InderveerS/LineFollower/3D Models/wheel.SLDPRT

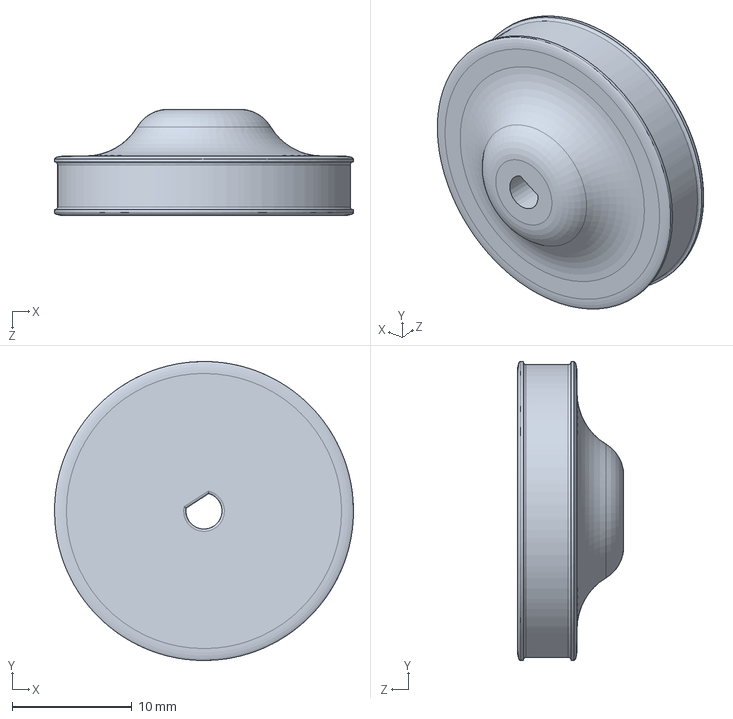
[picture p1: CAD file, 2026-05-06]
3D Models/wheel.SLDPRT
25.0 x 25.0 x 8.90 mm
