InderveerS/LineFollower/3D Models/frrontMount.SLDPRT

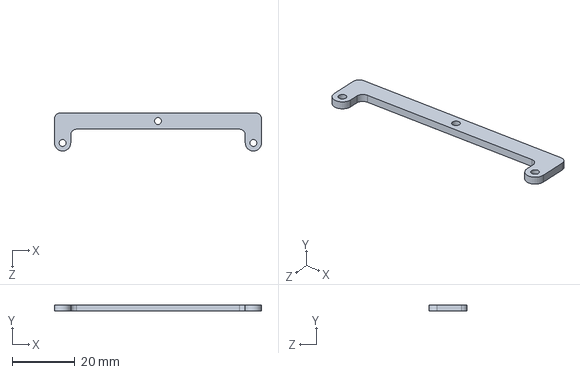
[picture p2: CAD file, 2026-05-06]
3D Models/frrontMount.SLDPRT
66.2 x 2.00 x 12.2 mm
