InderveerS/LineFollower/3D Models/frontMount.SLDPRT

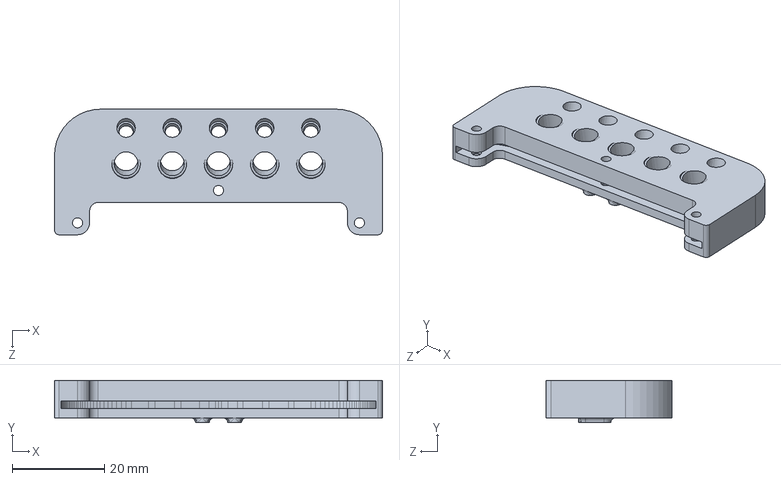
[picture p3: CAD file, 2026-05-06]
3D Models/frontMount.SLDPRT
71.0 x 9.12 x 27.2 mm
