InderveerS/LineFollower/3D Models/OPTO-TH_BD3.8-P2.54_SFH-309-FA-4.step

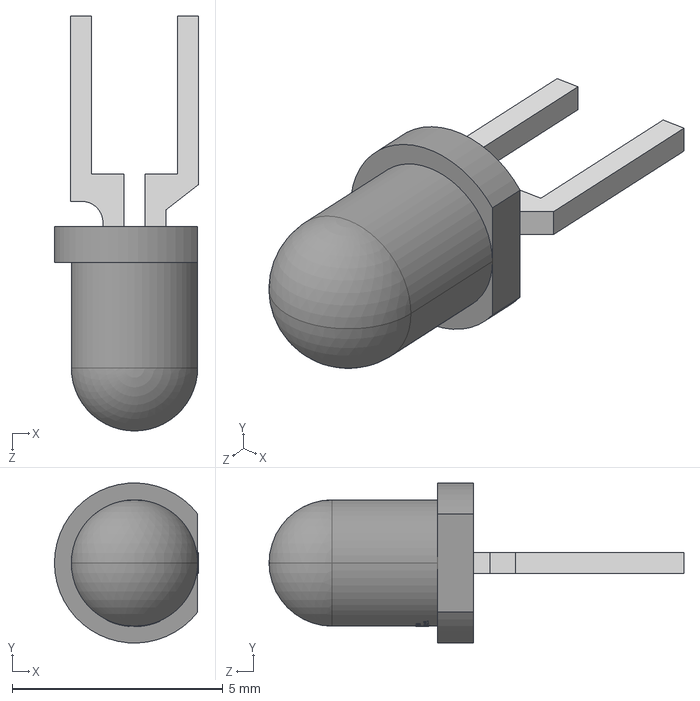
[picture p4: CAD file, 2026-05-06]
3D Models/OPTO-TH_BD3.8-P2.54_SFH-309-FA-4.step
3.42 x 3.80 x 9.85 mm
