InderveerS/LineFollower/3D Models/Micro Metal Gear Motor.SLDPRT

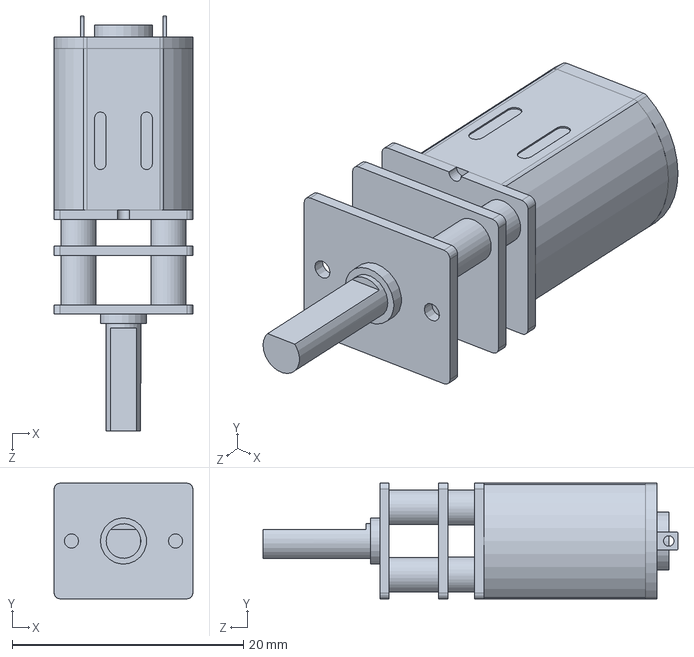
[picture p5: CAD file, 2026-05-06]
3D Models/Micro Metal Gear Motor.SLDPRT
12.0 x 10.0 x 35.9 mm
