InderveerS/LineFollower/3D Models/LED-TH_5mm_YG.step

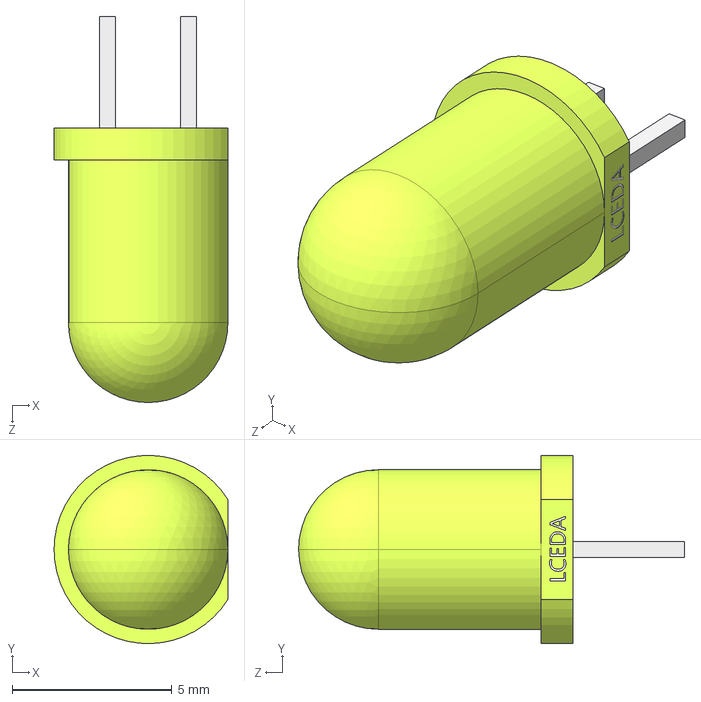
[picture p6: CAD file, 2026-05-06]
3D Models/LED-TH_5mm_YG.step
5.45 x 5.90 x 12.1 mm
