InderveerS/LineFollower/3D Models/motorMount.SLDPRT

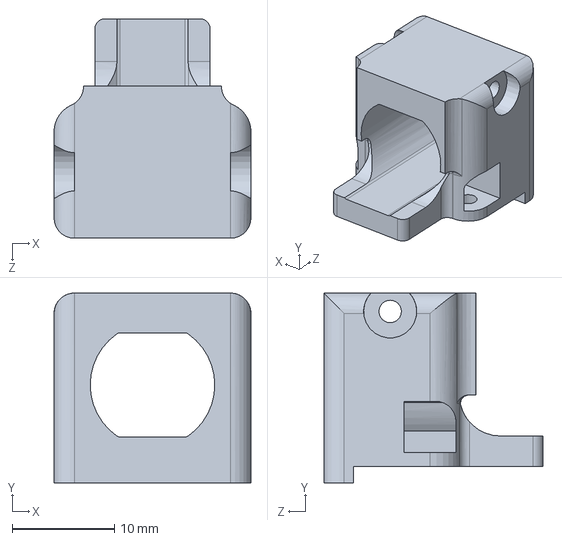
[picture p7: CAD file, 2026-05-06]
3D Models/motorMount.SLDPRT
19.3 x 18.6 x 21.5 mm
