InderveerS/LineFollower/finalTuneTest.xlsx

=~=~=~=~=~=~=~=~=~=~=~= PuTTY log 2026.09.06 22:22:52 =~=~=~=~=~=~=~=~=~=~=~=
target_mmps | left_mmps | right_mmps | left_duty | right_duty
200 | 0 | 0 | 39 | 39
200 | 9 | 0 | 39 | 39
200 | 19 | 9 | 39 | 39
200 | 48 | 28 | 37 | 38
200 | 67 | 57 | 36 | 37
200 | 86 | 86 | 35 | 35
200 | 115 | 105 | 34 | 34
200 | 125 | 125 | 33 | 33
200 | 144 | 134 | 32 | 33
200 | 153 | 144 | 32 | 32
200 | 153 | 153 | 32 | 32
200 | 163 | 163 | 31 | 31
200 | 173 | 173 | 31 | 31
200 | 182 | 182 | 30 | 30
200 | 182 | 192 | 30 | 30
200 | 182 | 192 | 30 | 30
200 | 182 | 192 | 30 | 30
200 | 192 | 192 | 30 | 30
200 | 202 | 192 | 29 | 30
200 | 202 | 202 | 29 | 29
200 | 202 | 202 | 29 | 29
200 | 202 | 202 | 29 | 29
200 | 202 | 211 | 29 | 29
200 | 202 | 202 | 29 | 29
200 | 211 | 211 | 29 | 29
200 | 202 | 211 | 29 | 29
200 | 211 | 211 | 29 | 29
200 | 211 | 211 | 29 | 29
200 | 211 | 202 | 29 | 29
200 | 211 | 211 | 29 | 29
200 | 211 | 202 | 29 | 29
200 | 211 | 211 | 29 | 29
200 | 211 | 211 | 28 | 29
200 | 211 | 211 | 28 | 29
200 | 211 | 211 | 28 | 29
200 | 211 | 211 | 28 | 29
200 | 211 | 221 | 28 | 28
200 | 211 | 211 | 28 | 28
200 | 211 | 221 | 28 | 28
200 | 211 | 211 | 28 | 28
200 | 211 | 202 | 28 | 29
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
