InderveerS/LineFollower/PITuneTest1.xlsx

=~=~=~=~=~=~=~=~=~=~=~= PuTTY log 2026.09.06 21:41:21 =~=~=~=~=~=~=~=~=~=~=~=
target_mmps | left_mmps | right_mmps | left_duty | right_duty
200 | 0 | 0 | 32 | 32
200 | 0 | 0 | 34 | 34
200 | 19 | 9 | 35 | 35
200 | 28 | 28 | 36 | 36
200 | 48 | 48 | 36 | 36
200 | 76 | 76 | 35 | 35
200 | 86 | 96 | 36 | 35
200 | 105 | 105 | 35 | 35
200 | 125 | 125 | 35 | 35
200 | 134 | 134 | 35 | 35
200 | 144 | 153 | 35 | 34
200 | 163 | 163 | 34 | 34
200 | 173 | 173 | 34 | 34
200 | 182 | 192 | 33 | 33
200 | 202 | 192 | 32 | 33
200 | 202 | 202 | 32 | 32
200 | 211 | 211 | 32 | 32
200 | 211 | 211 | 32 | 31
200 | 211 | 211 | 31 | 31
200 | 221 | 221 | 31 | 31
200 | 221 | 221 | 31 | 30
200 | 221 | 211 | 30 | 31
200 | 221 | 221 | 30 | 30
200 | 221 | 221 | 30 | 30
200 | 221 | 221 | 30 | 30
200 | 230 | 221 | 29 | 30
200 | 230 | 221 | 29 | 29
200 | 230 | 221 | 28 | 29
200 | 230 | 221 | 28 | 29
200 | 221 | 230 | 28 | 28
200 | 221 | 221 | 28 | 28
200 | 221 | 221 | 28 | 28
200 | 221 | 211 | 28 | 29
200 | 230 | 211 | 27 | 29
200 | 221 | 221 | 27 | 28
200 | 221 | 211 | 27 | 28
200 | 221 | 221 | 27 | 28
200 | 211 | 221 | 27 | 27
200 | 221 | 211 | 27 | 28
200 | 211 | 221 | 27 | 27
200 | 211 | 211 | 27 | 28
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
