InderveerS/LineFollower/pOnlyTuneTest.xlsx

=~=~=~=~=~=~=~=~=~=~=~= PuTTY log 2026.09.06 17:12:21 =~=~=~=~=~=~=~=~=~=~=~=
target_mmps | left_mmps | right_mmps | left_duty | right_duty
200 | 0 | 0 | 30 | 30
200 | 0 | 0 | 30 | 30
200 | 9 | 9 | 30 | 30
200 | 19 | 28 | 29 | 29
200 | 48 | 38 | 28 | 28
200 | 67 | 57 | 27 | 27
200 | 86 | 67 | 25 | 27
200 | 105 | 76 | 24 | 26
200 | 105 | 96 | 24 | 25
200 | 105 | 96 | 24 | 25
200 | 105 | 105 | 24 | 24
200 | 105 | 105 | 24 | 24
200 | 115 | 105 | 24 | 24
200 | 125 | 125 | 23 | 23
200 | 125 | 125 | 23 | 23
200 | 134 | 134 | 23 | 23
200 | 125 | 134 | 23 | 23
200 | 134 | 134 | 23 | 23
200 | 134 | 134 | 23 | 23
200 | 134 | 134 | 23 | 23
400 | 144 | 144 | 50 | 50
400 | 144 | 144 | 50 | 50
400 | 163 | 163 | 49 | 49
400 | 173 | 173 | 48 | 48
400 | 192 | 192 | 47 | 47
400 | 211 | 211 | 46 | 46
400 | 230 | 230 | 45 | 45
400 | 240 | 240 | 44 | 44
400 | 250 | 250 | 44 | 44
400 | 259 | 259 | 43 | 43
400 | 259 | 259 | 43 | 43
400 | 269 | 279 | 43 | 42
400 | 279 | 279 | 42 | 42
400 | 279 | 279 | 42 | 42
400 | 288 | 288 | 42 | 42
400 | 288 | 288 | 42 | 42
400 | 288 | 288 | 42 | 42
400 | 298 | 298 | 41 | 41
400 | 288 | 298 | 42 | 41
400 | 298 | 298 | 41 | 41
400 | 298 | 307 | 41 | 41
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
