InderveerS/LineFollower/PCB/lineFollower.kicad_pcb

## KiCad design PCB/lineFollower.kicad_pcb (2026-05-06)

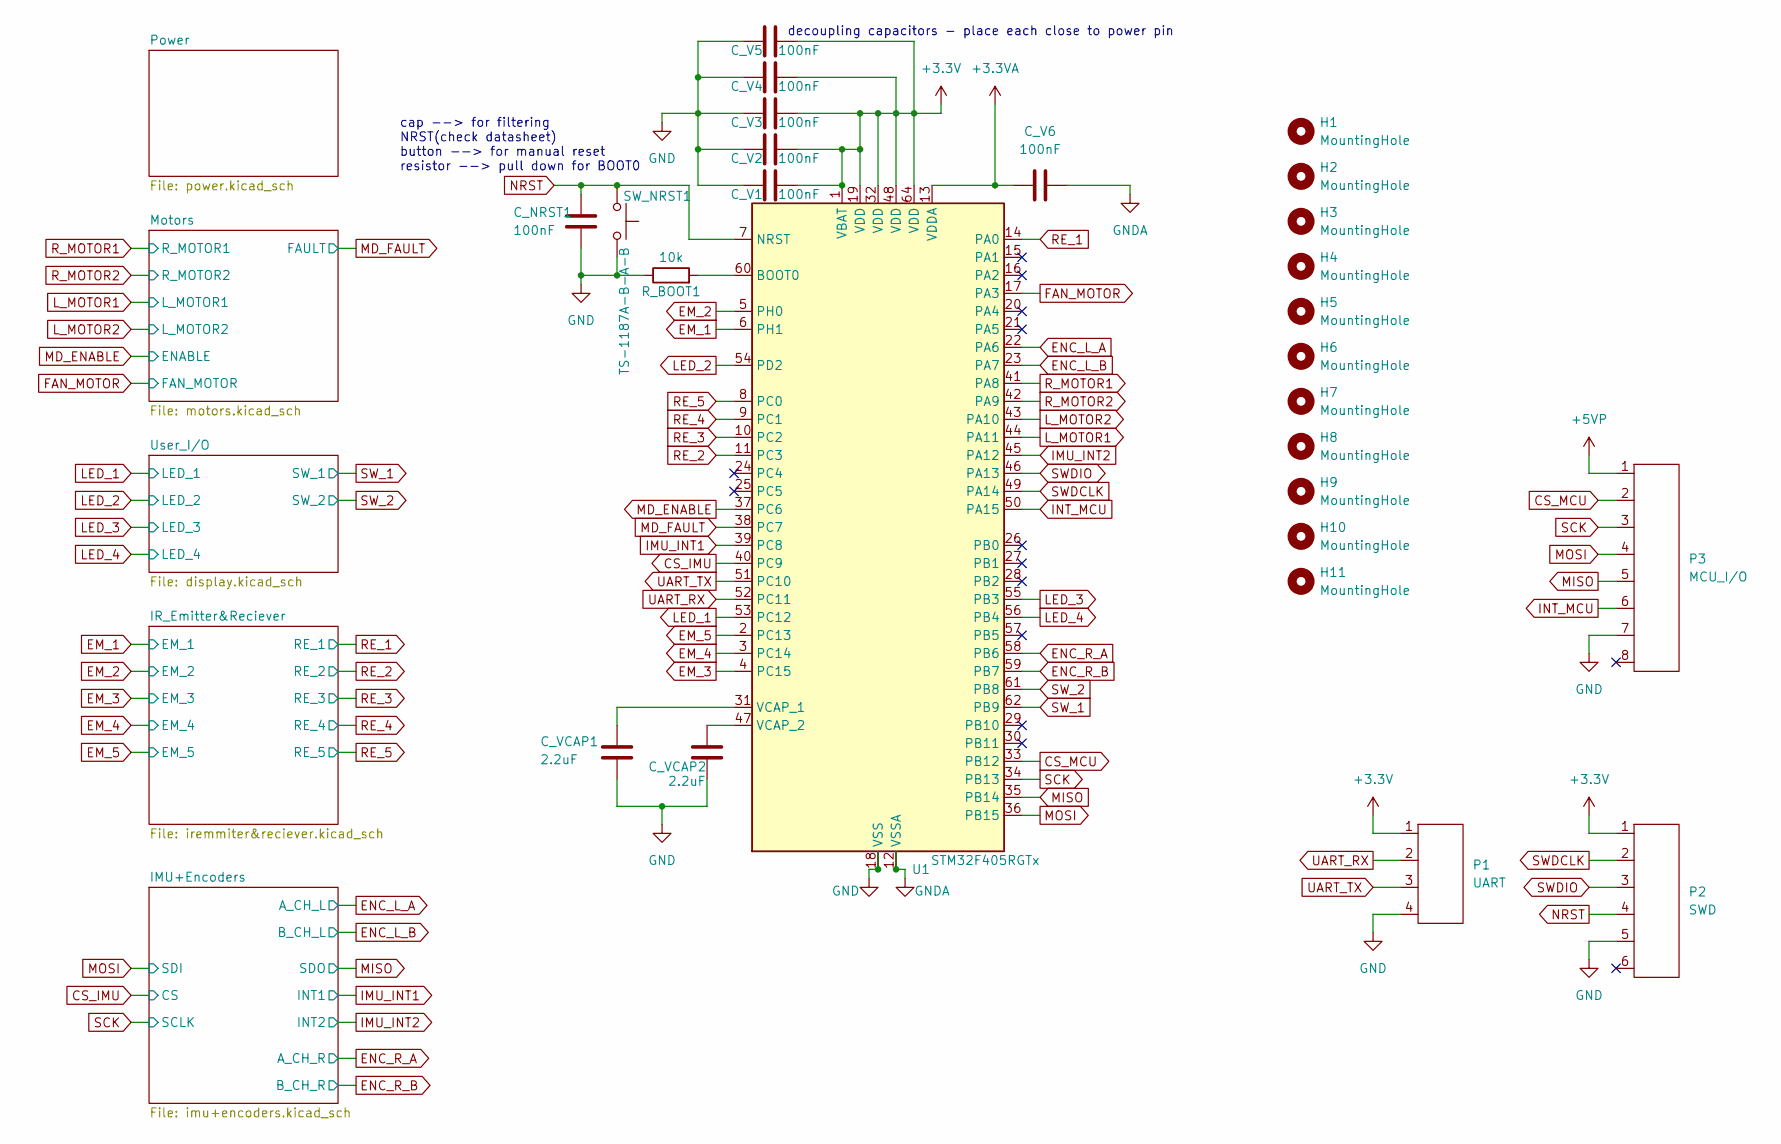
[picture p8: schematic lineFollower.kicad_sch]

Parts:
C_NRST1: 100nF; C_0603_1608Metric
C_V1, C_V2, C_V3, C_V4, C_V5, C_V6: 100nF; C_0603_1608Metric
C_VCAP1, C_VCAP2: 2.2uF; C_0603_1608Metric
H1, H2, H3, H4, H5, H6, H7, H8, H9, H10, H11: MountingHole; MountingHole_2.2mm_M2
P1: UART; PinHeader_1x04_P2.54mm_Vertical
P2: SWD; PinHeader_1x06_P2.54mm_Vertical
P3: MCU_I/O; PinHeader_1x08_P2.54mm_Vertical
R_BOOT1: 10k; R_0603_1608Metric
SW_NRST1: TS-1187A-B-A-B
U1: STM32F405RGTx; LQFP-64_10x10mm_P0.5mm

Connections:
+3.3V: C_V1.2, C_V2.2, C_V3.2, C_V4.2, C_V5.2, P1.1, P2.1, U1.1 (VBAT), U1.19 (VDD), U1.32 (VDD), U1.48 (VDD), U1.64 (VDD); also elsewhere on the board
+3.3VA: C_V6.1, U1.13 (VDDA); also elsewhere on the board
+5VP: P3.1; also elsewhere on the board
CS_IMU: U1.40 (PC9); also elsewhere on the board
CS_MCU: P3.2, U1.33 (PB12)
EM_1: U1.6 (PH1); also elsewhere on the board
EM_2: U1.5 (PH0); also elsewhere on the board
EM_3: U1.4 (PC15); also elsewhere on the board
EM_4: U1.3 (PC14); also elsewhere on the board
EM_5: U1.2 (PC13); also elsewhere on the board
ENC_L_A: U1.22 (PA6); also elsewhere on the board
ENC_L_B: U1.23 (PA7); also elsewhere on the board
ENC_R_A: U1.58 (PB6); also elsewhere on the board
ENC_R_B: U1.59 (PB7); also elsewhere on the board
FAN_MOTOR: U1.17 (PA3); also elsewhere on the board
GND: C_NRST1.2, C_V1.1, C_V2.1, C_V3.1, C_V4.1, C_V5.1, C_V6.2, C_VCAP1.2, C_VCAP2.2, P1.4, P2.5, P3.7, R_BOOT1.1, SW_NRST1.2, U1.12 (VSSA), U1.18 (VSS), U1.63 (VSS); also elsewhere on the board
IMU_INT1: U1.39 (PC8); also elsewhere on the board
IMU_INT2: U1.45 (PA12); also elsewhere on the board
INT_MCU: P3.6, U1.50 (PA15)
LED_1: U1.53 (PC12); also elsewhere on the board
LED_2: U1.54 (PD2); also elsewhere on the board
LED_3: U1.55 (PB3); also elsewhere on the board
LED_4: U1.56 (PB4); also elsewhere on the board
L_MOTOR1: U1.44 (PA11); also elsewhere on the board
L_MOTOR2: U1.43 (PA10); also elsewhere on the board
MD_ENABLE: U1.37 (PC6); also elsewhere on the board
MD_FAULT: U1.38 (PC7); also elsewhere on the board
MISO: P3.5, U1.35 (PB14); also elsewhere on the board
MOSI: P3.4, U1.36 (PB15); also elsewhere on the board
NRST: C_NRST1.1, P2.4, SW_NRST1.1, U1.7 (NRST)
unnamed: R_BOOT1.2, U1.60 (BOOT0)
unnamed: C_VCAP1.1, U1.31 (VCAP_1)
unnamed: C_VCAP2.1, U1.47 (VCAP_2)
RE_1: U1.14 (PA0); also elsewhere on the board
RE_2: U1.11 (PC3); also elsewhere on the board
RE_3: U1.10 (PC2); also elsewhere on the board
RE_4: U1.9 (PC1); also elsewhere on the board
RE_5: U1.8 (PC0); also elsewhere on the board
R_MOTOR1: U1.41 (PA8); also elsewhere on the board
R_MOTOR2: U1.42 (PA9); also elsewhere on the board
SCK: P3.3, U1.34 (PB13); also elsewhere on the board
SWDCLK: P2.2, U1.49 (PA14)
SWDIO: P2.3, U1.46 (PA13)
SW_1: U1.62 (PB9); also elsewhere on the board
SW_2: U1.61 (PB8); also elsewhere on the board
UART_RX: P1.2, U1.52 (PC11)
UART_TX: P1.3, U1.51 (PC10)

Notes on the sheet:
decoupling capacitors - place each close to power pin
cap --> for filtering NRST(check datasheet) button --> for manual reset resistor --> pull down for BOOT0

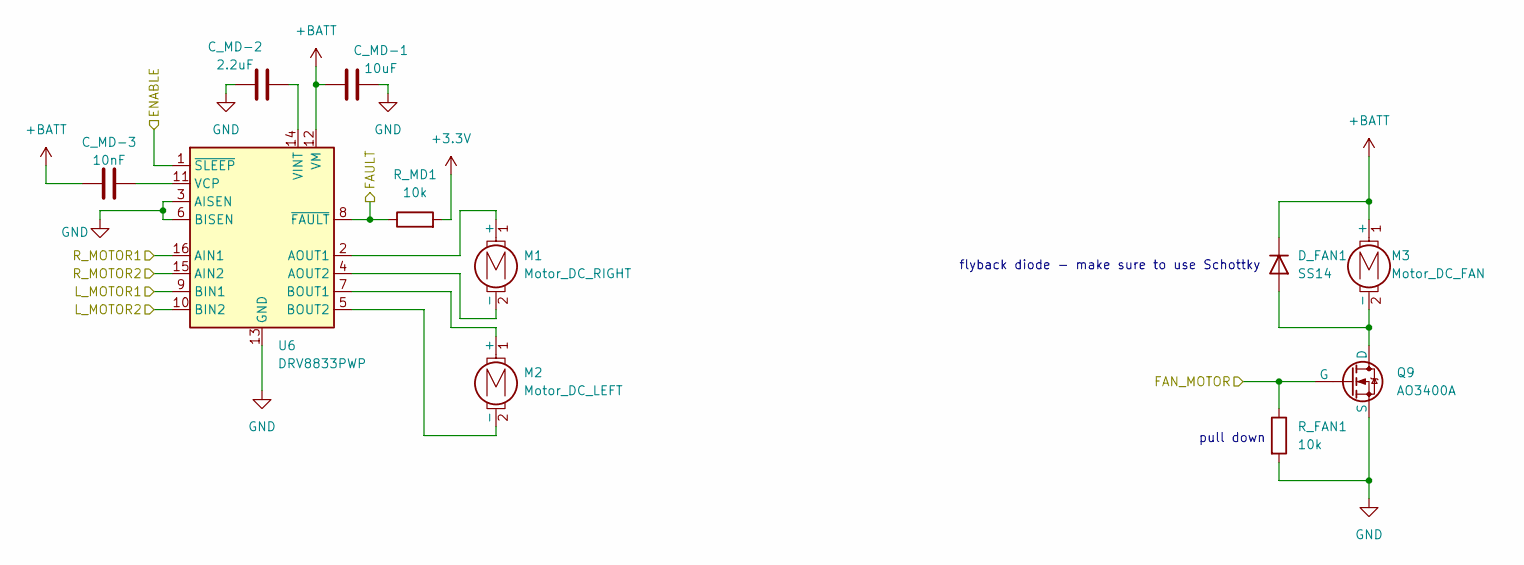
[picture p9: schematic motors.kicad_sch]

Parts:
C_MD-1: 10uF; C_0805_2012Metric
C_MD-2: 2.2uF; C_0603_1608Metric
C_MD-3: 10nF; C_0603_1608Metric
D_FAN1: SS14; D_SMA
M1: Motor_DC_RIGHT; PinHeader_1x02_P2.54mm_Vertical
M2: Motor_DC_LEFT; PinHeader_1x02_P2.54mm_Vertical
M3: Motor_DC_FAN; PinHeader_1x02_P2.54mm_Vertical
Q9: AO3400A
R_FAN1: 10k; R_0603_1608Metric
R_MD1: 10k; R_0603_1608Metric
U6: DRV8833PWP; HTSSOP-16-1EP_4.4x5mm_P0.65mm_EP3.4x5mm_Mask2.46x2.31mm_The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

Connections:
+3.3V: R_MD1.2; also elsewhere on the board
+BATT: C_MD-1.1, C_MD-3.1, D_FAN1.1 (K), M3.1 (+), U6.12 (VM); also elsewhere on the board
FAN_MOTOR: Q9.2 (G), R_FAN1.1; also elsewhere on the board
GND: C_MD-1.2, C_MD-2.1, Q9.3 (S), R_FAN1.2, U6.3 (AISEN), U6.6 (BISEN), U6.13 (GND), U6.17 (GND); also elsewhere on the board
L_MOTOR1: U6.9 (BIN1); also elsewhere on the board
L_MOTOR2: U6.10 (BIN2); also elsewhere on the board
MD_ENABLE: U6.1 (~SLEEP); also elsewhere on the board
MD_FAULT: R_MD1.1, U6.8 (~FAULT); also elsewhere on the board
unnamed: D_FAN1.2 (A), M3.2 (-), Q9.1 (D)
unnamed: M1.1 (+), U6.2 (AOUT1)
unnamed: M1.2 (-), U6.4 (AOUT2)
unnamed: M2.1 (+), U6.7 (BOUT1)
unnamed: M2.2 (-), U6.5 (BOUT2)
unnamed: C_MD-3.2, U6.11 (VCP)
unnamed: C_MD-2.2, U6.14 (VINT)
R_MOTOR1: U6.16 (AIN1); also elsewhere on the board
R_MOTOR2: U6.15 (AIN2); also elsewhere on the board

Notes on the sheet:
pull down
flyback diode - make sure to use Schottky

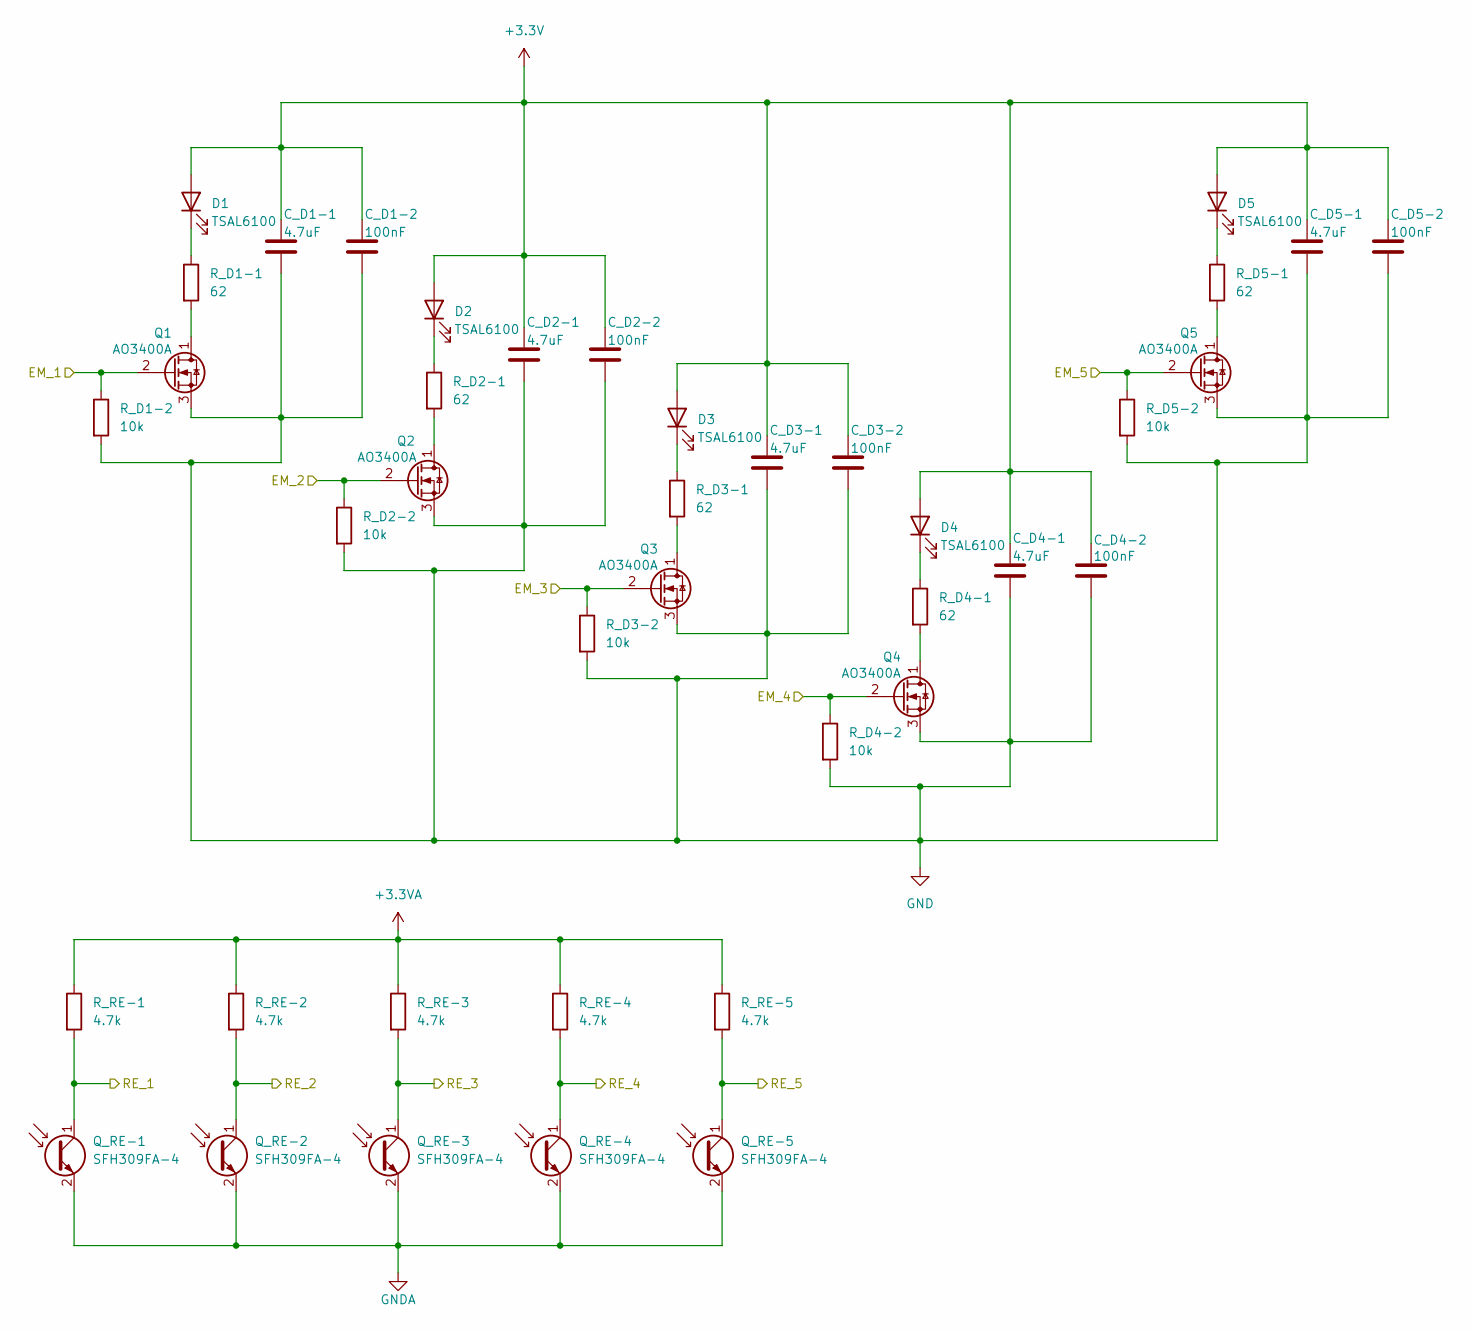
[picture p10: schematic iremmiter&reciever.kicad_sch]

Parts:
C_D1-1, C_D2-1, C_D3-1, C_D4-1, C_D5-1: 4.7uF; C_0805_2012Metric
C_D1-2, C_D2-2, C_D3-2, C_D4-2, C_D5-2: 100nF; C_0603_1608Metric
D1, D2, D3, D4, D5: TSAL6100; PinHeader_1x02_P2.54mm_Vertical
Q1, Q2, Q3, Q4, Q5: AO3400A
Q_RE-1, Q_RE-2, Q_RE-3, Q_RE-4, Q_RE-5: SFH309FA-4; PinHeader_1x02_P2.54mm_Vertical
R_D1-1, R_D2-1, R_D3-1, R_D4-1, R_D5-1: 62; R_0603_1608Metric
R_D1-2, R_D2-2, R_D3-2, R_D4-2, R_D5-2: 10k; R_0603_1608Metric
R_RE-1, R_RE-2, R_RE-3, R_RE-4, R_RE-5: 4.7k; R_0603_1608Metric

Connections:
+3.3V: C_D1-1.1, C_D1-2.1, C_D2-1.1, C_D2-2.1, C_D3-1.1, C_D3-2.1, C_D4-1.1, C_D4-2.1, C_D5-1.1, C_D5-2.1, D1.2 (A), D2.2 (A), D3.2 (A), D4.2 (A), D5.2 (A); also elsewhere on the board
+3.3VA: R_RE-1.1, R_RE-2.1, R_RE-3.1, R_RE-4.1, R_RE-5.1; also elsewhere on the board
EM_1: Q1.2 (G), R_D1-2.1; also elsewhere on the board
EM_2: Q2.2 (G), R_D2-2.1; also elsewhere on the board
EM_3: Q3.2 (G), R_D3-2.1; also elsewhere on the board
EM_4: Q4.2 (G), R_D4-2.1; also elsewhere on the board
EM_5: Q5.2 (G), R_D5-2.1; also elsewhere on the board
GND: C_D1-1.2, C_D1-2.2, C_D2-1.2, C_D2-2.2, C_D3-1.2, C_D3-2.2, C_D4-1.2, C_D4-2.2, C_D5-1.2, C_D5-2.2, Q1.3 (S), Q2.3 (S), Q3.3 (S), Q4.3 (S), Q5.3 (S), Q_RE-1.2 (E), Q_RE-2.2 (E), Q_RE-3.2 (E), Q_RE-4.2 (E), Q_RE-5.2 (E), R_D1-2.2, R_D2-2.2, R_D3-2.2, R_D4-2.2, R_D5-2.2; also elsewhere on the board
unnamed: D1.1 (K), R_D1-1.1
unnamed: D2.1 (K), R_D2-1.1
unnamed: D3.1 (K), R_D3-1.1
unnamed: D4.1 (K), R_D4-1.1
unnamed: D5.1 (K), R_D5-1.1
unnamed: Q1.1 (D), R_D1-1.2
unnamed: Q2.1 (D), R_D2-1.2
unnamed: Q3.1 (D), R_D3-1.2
unnamed: Q4.1 (D), R_D4-1.2
unnamed: Q5.1 (D), R_D5-1.2
RE_1: Q_RE-1.1 (C), R_RE-1.2; also elsewhere on the board
RE_2: Q_RE-2.1 (C), R_RE-2.2; also elsewhere on the board
RE_3: Q_RE-3.1 (C), R_RE-3.2; also elsewhere on the board
RE_4: Q_RE-4.1 (C), R_RE-4.2; also elsewhere on the board
RE_5: Q_RE-5.1 (C), R_RE-5.2; also elsewhere on the board

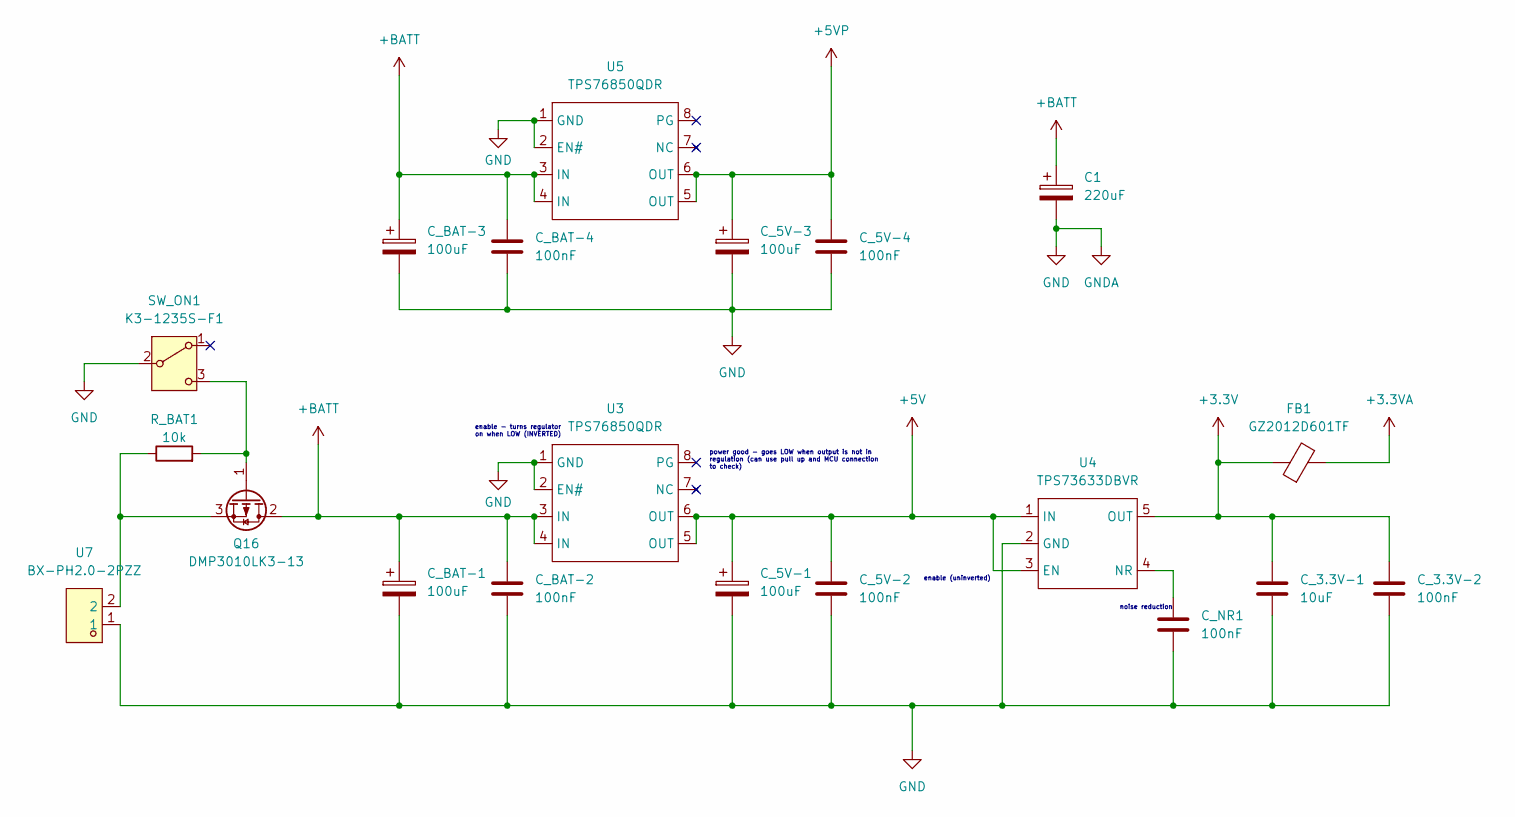
[picture p11: schematic power.kicad_sch]

Parts:
C1: 220uF; CP_Elec_8x10
C_3.3V-1: 10uF; C_0805_2012Metric
C_3.3V-2, C_5V-2, C_5V-4: 100nF; C_0603_1608Metric
C_5V-1, C_5V-3: 100uF; CP_Elec_5x5.4
C_BAT-1, C_BAT-3: 100uF; CP_Elec_5x5.4
C_BAT-2, C_BAT-4: 100nF; C_0603_1608Metric
C_NR1: 100nF; C_0603_1608Metric
FB1: GZ2012D601TF; L_0805_2012Metric
Q16: DMP3010LK3-13; TO-252-2
R_BAT1: 10k; R_0603_1608Metric
SW_ON1: K3-1235S-F1
U3, U5: TPS76850QDR; SOIC-8_3.9x4.9mm_P1.27mm
U4: TPS73633DBVR; SOT-23-5
U7: BX-PH2.0-2PZZ; CONN-TH_2P-P2.00_BOSSIE_BX-PH2.0-2PZZ; MPN BX-PH2.0-2PZZ; LCSC Part C18077744

Connections:
+3.3V: C_3.3V-1.1, C_3.3V-2.1, FB1.1, U4.5 (OUT); also elsewhere on the board
+3.3VA: FB1.2; also elsewhere on the board
+5V: C_5V-1.1, C_5V-2.1, U3.5 (OUT), U3.6 (OUT), U4.1 (IN), U4.3 (EN)
+5VP: C_5V-3.1, C_5V-4.1, U5.5 (OUT), U5.6 (OUT); also elsewhere on the board
+BATT: C1.1, C_BAT-1.1, C_BAT-2.1, C_BAT-3.1, C_BAT-4.1, Q16.2 (D), U3.3 (IN), U3.4 (IN), U5.3 (IN), U5.4 (IN); also elsewhere on the board
GND: C1.2, C_3.3V-1.2, C_3.3V-2.2, C_5V-1.2, C_5V-2.2, C_5V-3.2, C_5V-4.2, C_BAT-1.2, C_BAT-2.2, C_BAT-3.2, C_BAT-4.2, C_NR1.2, SW_ON1.2 (B), U3.1 (GND), U3.2 (EN#), U4.2 (GND), U5.1 (GND), U5.2 (EN#), U7.1; also elsewhere on the board
unnamed: Q16.1 (G), R_BAT1.2, SW_ON1.3 (C)
unnamed: Q16.3 (S), R_BAT1.1, U7.2
unnamed: C_NR1.1, U4.4 (NR)

Notes on the sheet:
enable (uninverted)
power good - goes LOW when output is not in regulation (can use pull up and MCU connection to check)
enable - turns regulator on when LOW (INVERTED)
noise reduction

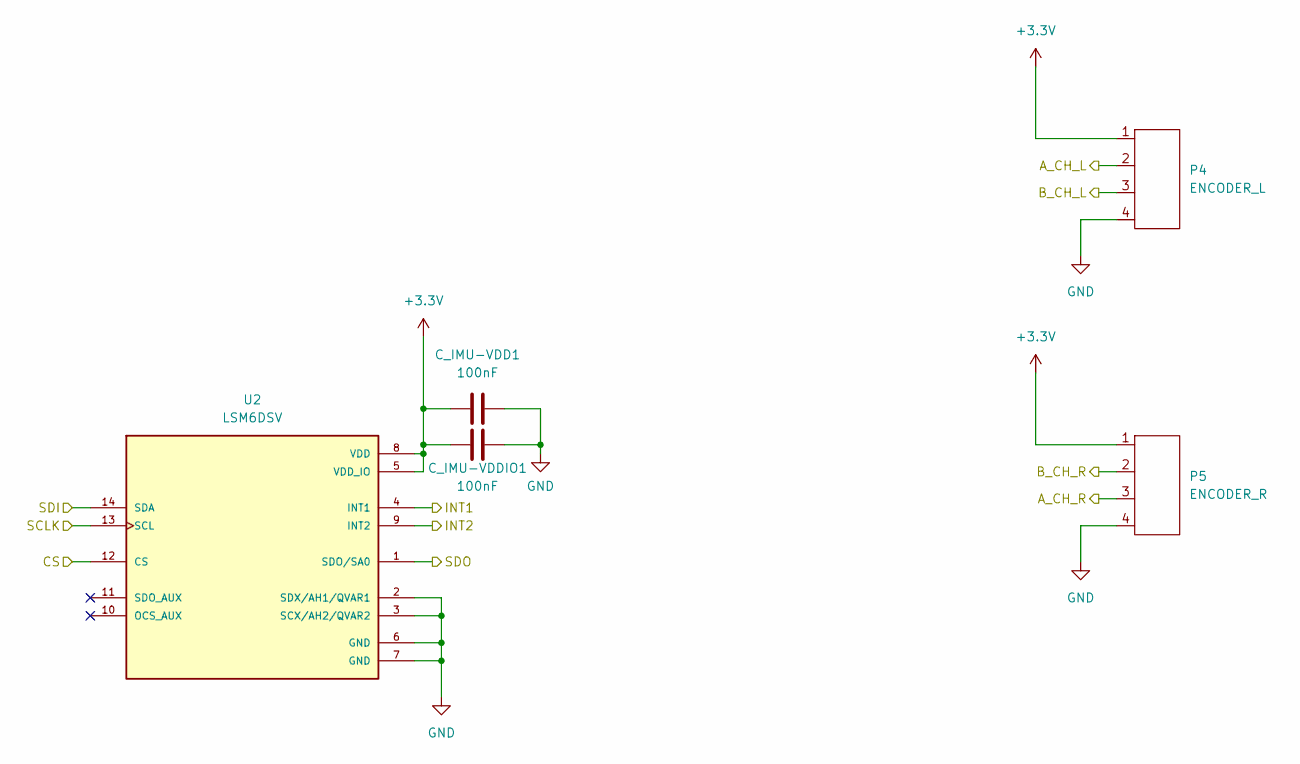
[picture p12: schematic imu+encoders.kicad_sch]

Parts:
C_IMU-VDD1: 100nF; C_0603_1608Metric
C_IMU-VDDIO1: 100nF; C_0603_1608Metric
P4: ENCODER_L; PinHeader_1x04_P2.54mm_Vertical
P5: ENCODER_R; PinHeader_1x04_P2.54mm_Vertical
U2: LSM6DSV; XDCR_LSM6DSV

Connections:
+3.3V: C_IMU-VDD1.1, C_IMU-VDDIO1.1, P4.1, P5.1, U2.5 (VDD_IO), U2.8 (VDD); also elsewhere on the board
CS_IMU: U2.12 (CS); also elsewhere on the board
ENC_L_A: P4.2; also elsewhere on the board
ENC_L_B: P4.3; also elsewhere on the board
ENC_R_A: P5.3; also elsewhere on the board
ENC_R_B: P5.2; also elsewhere on the board
GND: C_IMU-VDD1.2, C_IMU-VDDIO1.2, P4.4, P5.4, U2.2 (SDX/AH1/QVAR1), U2.3 (SCX/AH2/QVAR2), U2.6 (GND), U2.7 (GND); also elsewhere on the board
IMU_INT1: U2.4 (INT1); also elsewhere on the board
IMU_INT2: U2.9 (INT2); also elsewhere on the board
MISO: U2.1 (SDO/SA0); also elsewhere on the board
MOSI: U2.14 (SDA); also elsewhere on the board
SCK: U2.13 (SCL); also elsewhere on the board

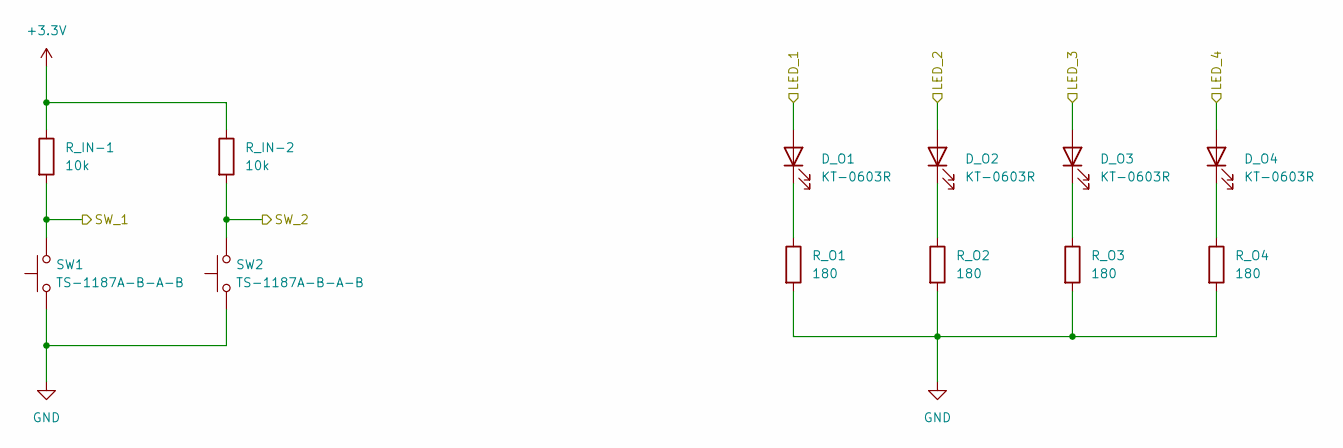
[picture p13: schematic display.kicad_sch]

Parts:
D_O1, D_O2, D_O3, D_O4: KT-0603R; LED_0603_1608Metric
R_IN-1, R_IN-2: 10k; R_0603_1608Metric
R_O1, R_O2, R_O3, R_O4: 180; R_0603_1608Metric
SW1, SW2: TS-1187A-B-A-B

Connections:
+3.3V: R_IN-1.1, R_IN-2.1; also elsewhere on the board
GND: R_O1.2, R_O2.2, R_O3.2, R_O4.2, SW1.1, SW2.1; also elsewhere on the board
LED_1: D_O1.2 (A); also elsewhere on the board
LED_2: D_O2.2 (A); also elsewhere on the board
LED_3: D_O3.2 (A); also elsewhere on the board
LED_4: D_O4.2 (A); also elsewhere on the board
unnamed: D_O1.1 (K), R_O1.1
unnamed: D_O2.1 (K), R_O2.1
unnamed: D_O3.1 (K), R_O3.1
unnamed: D_O4.1 (K), R_O4.1
SW_1: R_IN-1.2, SW1.2; also elsewhere on the board
SW_2: R_IN-2.2, SW2.2; also elsewhere on the board

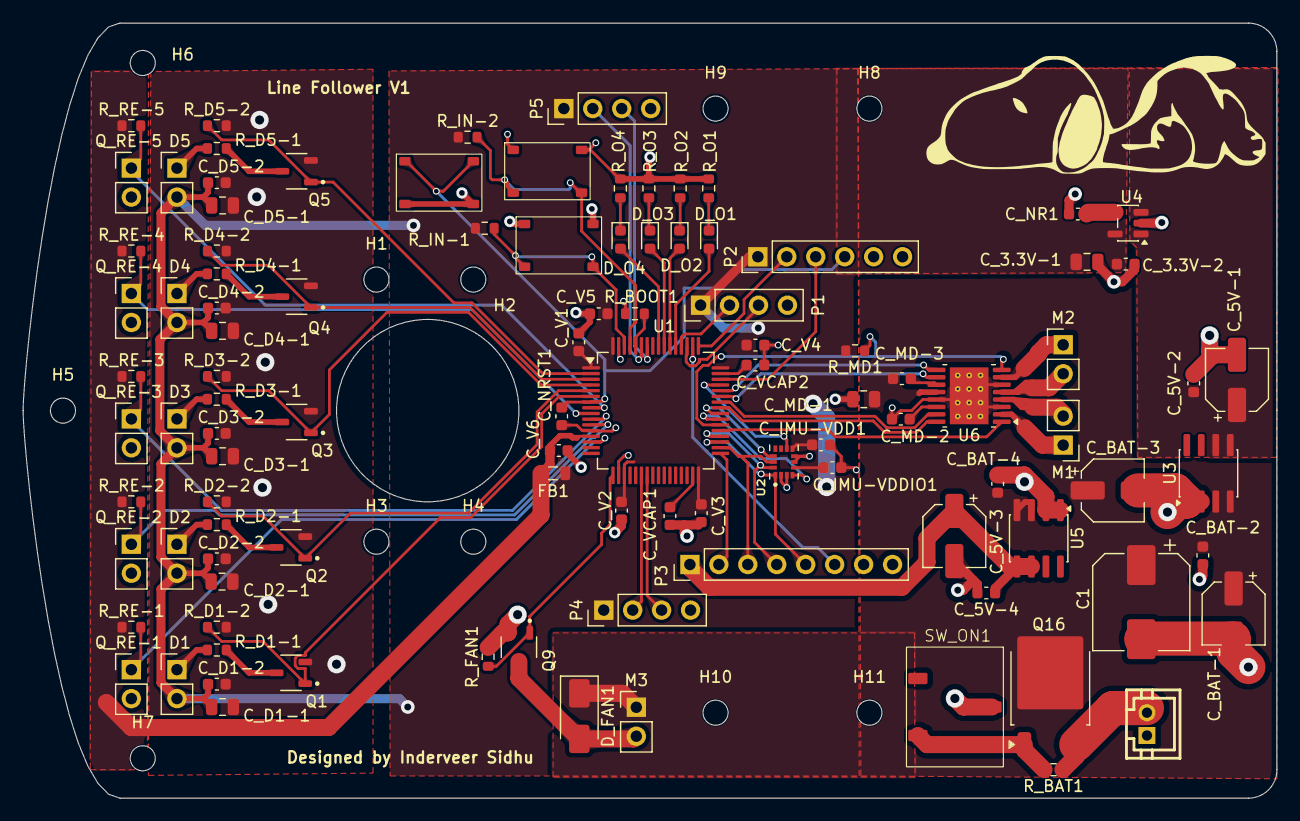
[picture p14: board lineFollower.kicad_pcb from above]

Board: 2 copper layers, 110.0 x 68.0 mm, 114 parts (0 on the bottom side), 73 nets.
