InderveerS/LineFollower/softwareHere/allSoftware/Core/Src/main.c

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
/* Includes ------------------------------------------------------------------*/
#include "main.h"

/* USER CODE BEGIN Includes */
#include "motors.h"
#include "data_logging.h"
#include "control.h"
#include "bench.h"
#include "sensors.h"
#include <stdio.h>
#include <string.h>
#include <stdlib.h>
/* USER CODE END Includes */

ADC_HandleTypeDef hadc1;
DMA_HandleTypeDef hdma_adc1;

SPI_HandleTypeDef hspi2;

TIM_HandleTypeDef htim1;
TIM_HandleTypeDef htim3;
TIM_HandleTypeDef htim4;
TIM_HandleTypeDef htim5;
TIM_HandleTypeDef htim6;

UART_HandleTypeDef huart3;

/* USER CODE BEGIN PV */

//volatile uint16_t farLeftIR = 0;
//volatile uint16_t leftIR = 0;
//volatile uint16_t middleIR = 0;
//volatile uint16_t rightIR = 0;
//volatile uint16_t farRightIR = 0;

/* USER CODE END PV */

void SystemClock_Config(void);
static void MX_GPIO_Init(void);
static void MX_DMA_Init(void);
static void MX_ADC1_Init(void);
static void MX_SPI2_Init(void);
static void MX_TIM1_Init(void);
static void MX_TIM3_Init(void);
static void MX_TIM4_Init(void);
static void MX_TIM5_Init(void);
static void MX_USART3_UART_Init(void);
static void MX_TIM6_Init(void);
/**
  * @brief  The application entry point.
  * @retval int
  */
int main(void)
{

  /* MCU Configuration--------------------------------------------------------*/

  /* Reset of all peripherals, Initializes the Flash interface and the Systick. */
  HAL_Init();

  /* Configure the system clock */
  SystemClock_Config();

  /* Initialize all configured peripherals */
  MX_GPIO_Init();
  MX_DMA_Init();
  MX_ADC1_Init();
  MX_SPI2_Init();
  MX_TIM1_Init();
  MX_TIM3_Init();
  MX_TIM4_Init();
  MX_TIM5_Init();
  MX_USART3_UART_Init();
  MX_TIM6_Init();
  /* USER CODE BEGIN 2 */
// TIM1->ARR = 8399;
// TIM1->EGR = TIM_EGR_UG;
 HAL_GPIO_WritePin(GPIOC, GPIO_PIN_6, GPIO_PIN_SET);
 HAL_TIM_PWM_Start(&htim1, TIM_CHANNEL_1);
 HAL_TIM_PWM_Start(&htim1, TIM_CHANNEL_2);
 HAL_TIM_PWM_Start(&htim1, TIM_CHANNEL_3);
 HAL_TIM_PWM_Start(&htim1, TIM_CHANNEL_4);
 HAL_TIM_Encoder_Start(&htim3, TIM_CHANNEL_ALL);
 HAL_TIM_Encoder_Start(&htim4, TIM_CHANNEL_ALL);
 // logging_init();
 controllerInit();
 irBuffInit();
 HAL_GPIO_WritePin(GPIOC, GPIO_PIN_13, GPIO_PIN_SET);
 HAL_GPIO_WritePin(GPIOC, GPIO_PIN_14, GPIO_PIN_SET);
 HAL_GPIO_WritePin(GPIOC, GPIO_PIN_15, GPIO_PIN_SET);
 HAL_GPIO_WritePin(GPIOH, GPIO_PIN_0, GPIO_PIN_SET);
 HAL_GPIO_WritePin(GPIOH, GPIO_PIN_1, GPIO_PIN_SET);
 HAL_TIM_Base_Start_IT(&htim6);
  /* USER CODE END 2 */

  /* Infinite loop */
  /* USER CODE BEGIN WHILE */

 while (1)
 {

//	 farLeftIR = getRawIR(0);
//	 leftIR = getRawIR(1);
//	 middleIR = getRawIR(2);
//	 rightIR = getRawIR(3);
//	 farRightIR = getRawIR(4);

//	 for(int i = 0; i < 100; i++) {
//		 spinPercent(i);
//		 HAL_Delay(50);
//	 }
//	 for(int i = 100; i > -100; i--) {
//		 spinPercent(i);
//		 HAL_Delay(50);
//	 }
//	 for(int i = -100; i < 0; i++) {
//		 spinPercent(i);
//		 HAL_Delay(50);
//	 }
//
//
//   uint8_t rx_char;
//   if (HAL_UART_Receive(&huart3, &rx_char, 1, 0) == HAL_OK)
//   {
//     switch (rx_char)
//     {
//       case 'S':
//       case 's':
//         logging_start();
//         break;
//       case 'D':
//       case 'd':
//         logging_dump_csv();
//         break;
//       case 'E':
//       case 'e':
//         logging_erase();
//         break;
//       default:
//         break;
//     }
//   }
    /* USER CODE END WHILE */

    /* USER CODE BEGIN 3 */
 }
  /* USER CODE END 3 */
}

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
/* USER CODE BEGIN 4 */
/**
 * @brief  Timer interrupt callback - fires when TIM6 overflows
 * @param  htim: pointer to a TIM_HandleTypeDef structure
 * @retval None
 */
void HAL_TIM_PeriodElapsedCallback(TIM_HandleTypeDef *htim) {
   if (htim->Instance != TIM6) return;

   benchTick();

   if (robotMode == MODE_RUN) controlTick();

   if (logging_active) {
       logging_record();
       log_time_ms += 5;

       if (log_time_ms >= 30000) logging_stop();
   }
}



/* USER CODE END 4 */
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
