InderveerS/LineFollower/softwareHere/allSoftware/pinsAndSettings.ioc

Mcu.UserName=STM32F405RGTx
PA0-WKUP.Signal=ADCx_IN0
PA10.Signal=S_TIM1_CH3
PA11.Signal=S_TIM1_CH4
PA12.Signal=GPIO_Input
PA13.Signal=SYS_JTMS-SWDIO
PA14.Signal=SYS_JTCK-SWCLK
PA15.Signal=GPIO_Input
PA3.Signal=S_TIM5_CH4
PA6.Signal=S_TIM3_CH1
PA7.Signal=S_TIM3_CH2
PA8.Signal=S_TIM1_CH1
PA9.Signal=S_TIM1_CH2
PB12.Signal=GPIO_Output
PB13.Signal=SPI2_SCK
PB14.Signal=SPI2_MISO
PB15.Signal=SPI2_MOSI
PB3.Signal=GPIO_Output
PB4.Signal=GPIO_Output
PB6.Signal=S_TIM4_CH1
PB7.Signal=S_TIM4_CH2
PB8.Signal=GPIO_Input
PB9.Signal=GPIO_Input
PC0.Signal=ADCx_IN10
PC1.Signal=ADCx_IN11
PC10.Signal=USART3_TX
PC11.Signal=USART3_RX
PC12.Signal=GPIO_Output
PC13-ANTI_TAMP.Signal=GPIO_Output
PC14-OSC32_IN.Signal=GPIO_Output
PC15-OSC32_OUT.Signal=GPIO_Output
PC2.Signal=ADCx_IN12
PC3.Signal=ADCx_IN13
PC6.Signal=GPIO_Output
PC7.Signal=GPIO_Input
PC8.Signal=GPIO_Input
PC9.Signal=GPIO_Output
PD2.Signal=GPIO_Output
PH0-OSC_IN.Signal=GPIO_Output
PH1-OSC_OUT.Signal=GPIO_Output
