InderveerS/LineFollower/softwareHere/allSoftware/Core/Inc/motors.h

/*
 * motors.h
 *
 *  Created on: May 8, 2026
 *      Author: inder
 */

#ifndef INC_MOTORS_H_
#define INC_MOTORS_H_

void spinCoast(void);
void spinBrake(void);
void coastRightMotor(void);
void coastLeftMotor(void);
void brakeRightMotor(void);
void brakeLeftMotor(void);
void spinPercent(int dutyPercent);
void spinRightMotor(int dutyPercent);
void spinLeftMotor(int dutyPercent);

#endif /* INC_MOTORS_H_ */
