InderveerS/LineFollower/(commit log)

2026-05-06 tweaked 3D Models
    [wheel.SLDPRT]
2026-05-11 Added Motor encoder data + logging over UART to flash memory
2026-05-18 Add Python script to receive and plot motor data from STM32
2026-05-18 added motor left right control
2026-05-18 motors.h made
2026-05-18 made pid.c
2026-05-18 Add PID controller header file
2026-05-18 Initialize PWM and encoder for TIM1 and TIM3
2026-05-18 Refactored motor data handling
2026-05-19 Added Code to make Logging work
    [motor_data.csv]
2026-06-01 changed gitignore, added controls and pid files
2026-06-02 finished controller, sensors, and added initialization in main
2026-06-12 added button-triggered logging with LED countdown and auto-stop
2026-09-10 V1 complete, Line Follower runs at 0.5 m/s base speed
    [PITuneTest1.xlsx, ffSweep.xlsx, finalTuneTest.xlsx, pOnlyTuneTest.xlsx]
